ACEVS4US/ENVIRONMENT_BOARD/Environment2.brd

## EAGLE design Environment2.brd (2021-01-10)

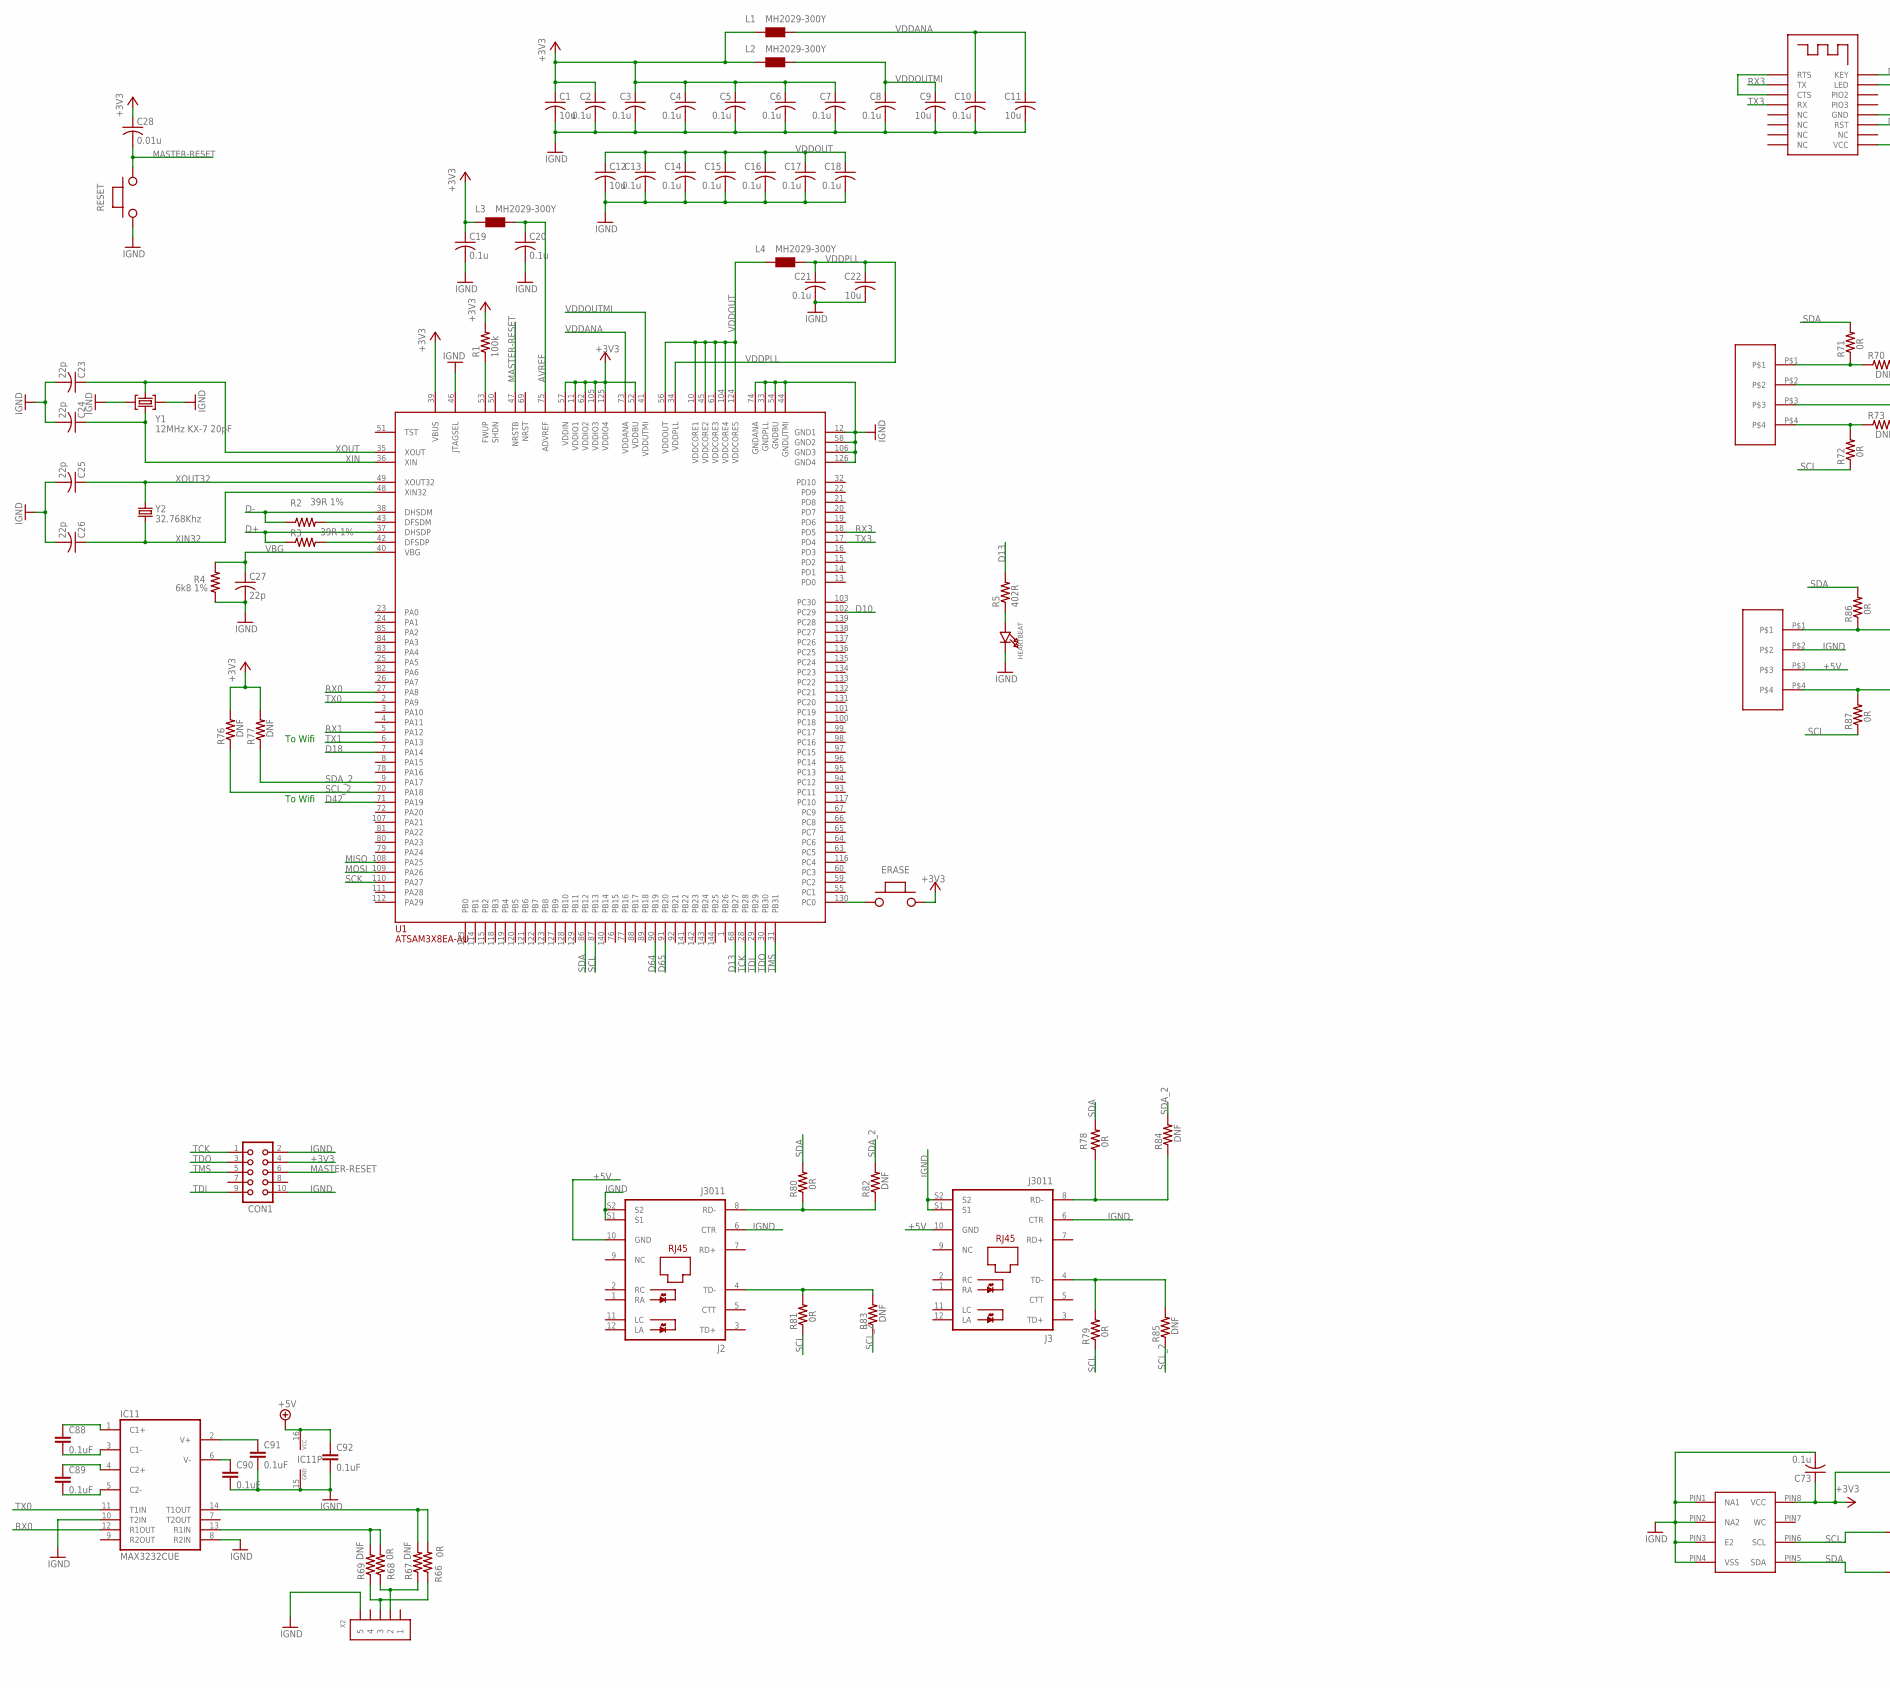
[picture p1: schematic Environment2.sch, part in row 1, column 1]

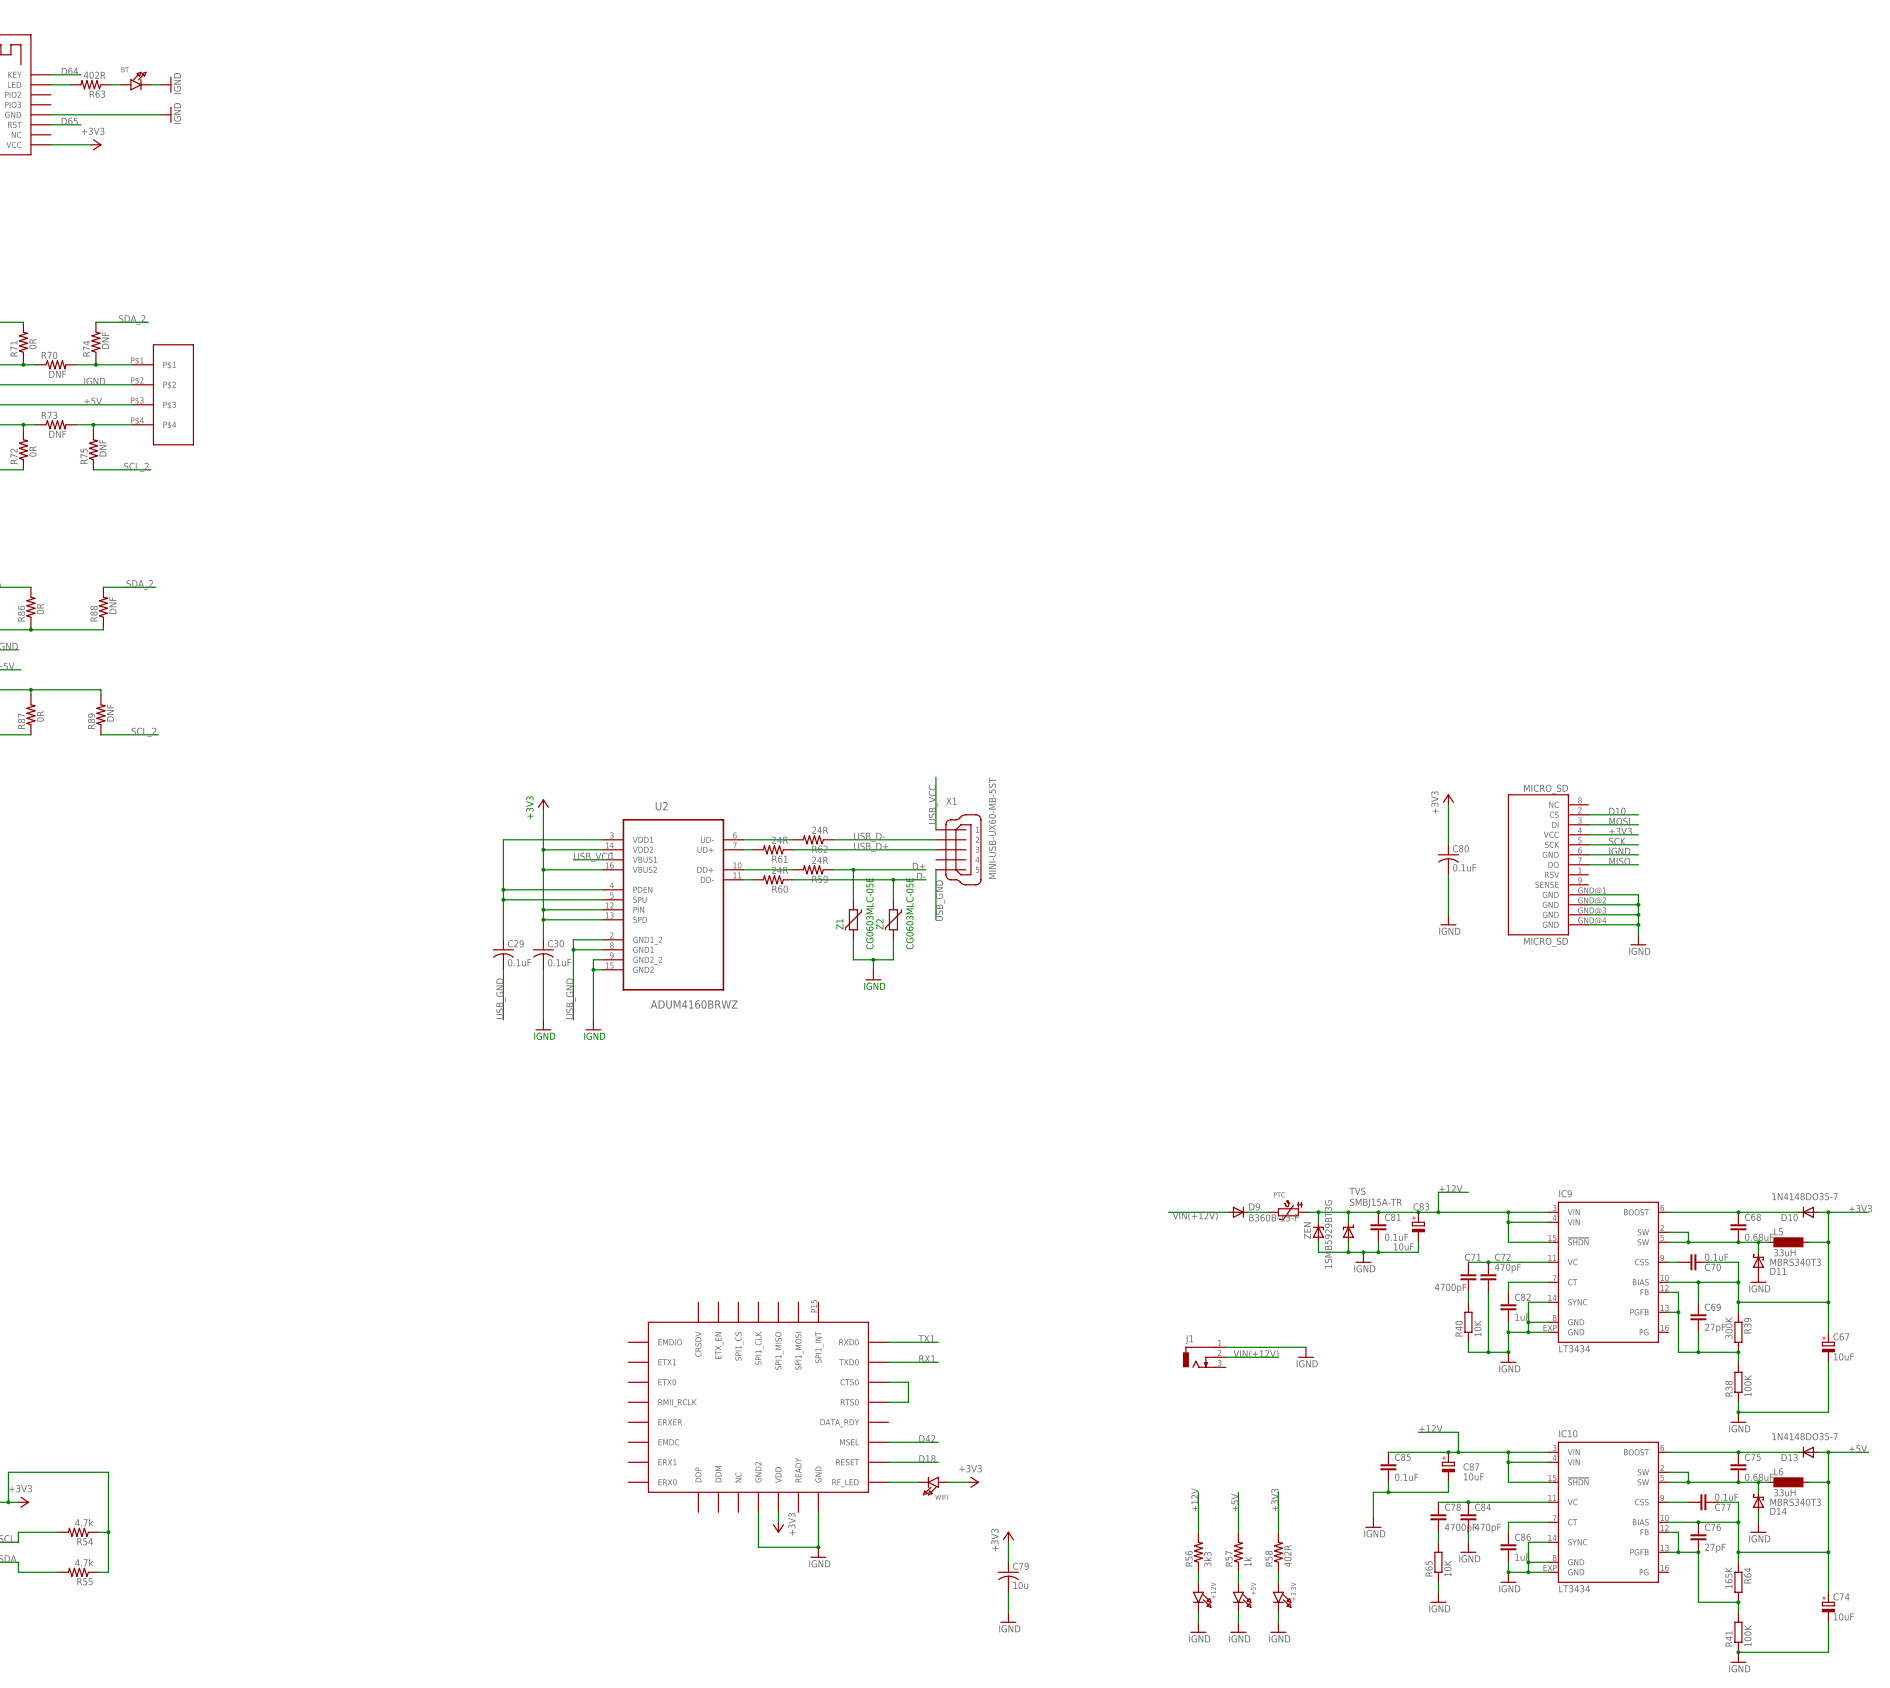
[picture p2: schematic Environment2.sch, part in row 1, column 2]

Parts:
+3.3V, +5V, +12V: LED0805; CHIPLED_0805
BT: LED0805; CHIPLED_0805
C1, C9, C11, C12, C22, C79: 10u; C0805
C2, C3, C4, C5, C6, C7, C8, C10, C13, C14, C15, C16, C17, C18, C19, C20, C21, C73: 0.1u; C0805
C23, C24: 22p; C1206
C25, C26, C27: 22p; C0805
C28: 0.01u; C0805
C29, C30, C80: 0.1uF; C0805
C67, C74, C83, C87: 10uF; SMC_D
C68, C75: 0.68uF; C0603
C69, C76: 27pF; C0603
C70, C77, C81, C85, C88, C89, C90, C91, C92: 0.1uF; C0603
C71, C78: 4700pF; C0603
C72, C84: 470pF; C0603
C82, C86: 1uF; C0603
CON1: CON10
D9: B360B-13-F; SMB
D10, D13: 1N4148DO35-7; DO35-7
D11, D14: MBRS340T3; SMC
ERASE: PUCHBUTTON
HEARTBEAT: LED0805; CHIPLED_0805
IC9, IC10: LT3434; TSSOP16EXP
IC11: MAX3232CUE; TSSOP16
J1: DCJ0303
J2, J3: J3011; J30
L1, L2, L3, L4: MH2029-300Y; 0805
L5, L6: 33uH; MS85
MICRO_SD: MICRO_SD; MICROSD_PP
PTC: PTC1812
R1: 100k; R0805
R2, R3: 39R 1%; R0805
R4: 6k8 1%; R0805
R5, R58, R63: 402R; R0805
R38, R41: 100K; R0603
R39: 300K; R0603
R40, R65: 10K; R0603
R54, R55: 4.7k; R0805
R56: 3k3; R0805
R57: 1k; R0805
R59, R60, R61, R62: 24R; R0805
R64: 165K; R0603
R66, R68, R71, R72, R78, R79, R80, R81, R86, R87: 0R; R0805
R67, R69, R70, R73, R74, R75, R76, R77, R82, R83, R84, R85, R88, R89: DNF; R0805
RESET: PUCHBUTTON
TVS: SMBJ15A-TR; SMBJ
U1: ATSAM3X8EA-AU; LQFP144
U2: ADUM4160BRWZ; SOIC127P1032X265-16N
U7: CK_CUSTOM_M24M02-DRMN6TP; CK_CUSTOM_SOIC8
U8, U9, U10: 560020-04; 560020-4
U$1: NANOREACH
U$3: HM-13
WIFI: LED0805; CHIPLED_0805
X1: MINI-USB-UX60-MB-5ST; UX60-MB-5ST
X2: CONN_5-1-502386; CM-502386-05
Y1: 12MHz KX-7 20pF; CRYSTAL-3.2-2.5
Y2: 32.768Khz; ARDUINO_WIFI_SHIELD_V018_TG_RESONATOR_EPSON_FC_145
Z1, Z2: CG0603MLC-05E; CT/CN0603
ZEN: 1SMB5929BT3G; SMB

Connections:
+3V3: C1.1, C2.1, C3.1, C4.1, C5.1, C6.1, C7.1, C19.1, C28.1, C30.1, C67.+, C69.1, C70.2, C73.1, C79.1, C80.1, CON1.4, D10.A, ERASE.P$2, IC9.10 (BIAS), L1.1, L2.1, L3.1, L5.2, MICRO_SD.4 (VCC), R1.2, R39.1, R54.1, R55.1, R58.2, R76.2, R77.2, U1.11 (VDDIO1), U1.39 (VBUS), U1.52 (VDDBU), U1.57 (VDDIN), U1.62 (VDDIO2), U1.105 (VDDIO3), U1.125 (VDDIO4), U2.12 (PIN), U2.13 (SPD), U2.14 (VDD2), U2.16 (VBUS2), U7.PIN8 (VCC), U$1.P1 (VDD), U$3.P$9 (VCC), WIFI.A
+5V: C74.+, C76.1, C77.2, C92.1, D13.A, IC10.10 (BIAS), IC11.16 (VCC), J2.10 (GND), L6.2, R57.2, R64.1, U8.P$3, U9.P$3, U10.P$3
+12V: C81.1, C83.+, C85.1, C87.+, IC9.3 (VIN), IC9.4 (VIN), IC9.15 (!SHDN), IC10.3 (VIN), IC10.4 (VIN), IC10.15 (!SHDN), PTC.P$1 (1), R56.2, TVS.C, ZEN.C
A: R70.2, R74.1, U9.P$1
AVREF: C20.1, L3.2, U1.75 (ADVREF)
B: R73.2, R75.2, U9.P$4
D10: MICRO_SD.2 (CS), U1.102 (PC29)
D13: R5.2, U1.68 (PB27)
D18: U1.7 (PA14), U$1.P9 (RESET)
D42: U1.71 (PA19), U$1.P8 (MSEL)
D64: U1.90 (PB19), U$3.P$16 (KEY)
D65: U1.91 (PB20), U$3.P$11 (RST)
D+: R3.1, R59.1, U1.37 (DHSDP), Z1.1
D-: R2.1, R60.1, U1.38 (DHSDM), Z2.1
ERASE_S: ERASE.P$1, U1.130 (PC0)
IGND: +3.3V.C, +5V.C, +12V.C, BT.C, C1.2, C2.2, C3.2, C4.2, C5.2, C6.2, C7.2, C8.2, C9.2, C10.2, C11.2, C12.2, C13.2, C14.2, C15.2, C16.2, C17.2, C18.2, C19.2, C20.2, C21.2, C22.2, C23.2, C24.2, C25.2, C26.2, C27.2, C30.2, C67.-, C72.2, C73.2, C74.-, C79.2, C80.2, C81.2, C82.2, C83.-, C84.2, C85.2, C86.2, C87.-, C90.2, C91.2, C92.2, CON1.2, CON1.10, D11.A, D14.A, HEARTBEAT.C, IC9.8 (GND), IC9.14 (SYNC), IC9.EXP (GND), IC10.8 (GND), IC10.14 (SYNC), IC10.EXP (GND), IC11.8 (R2IN), IC11.10 (T2IN), IC11.15 (GND), J1.1, J2.6 (CTR), J2.S1, J2.S2, J3.6 (CTR), J3.S1, J3.S2, MICRO_SD.6 (GND), MICRO_SD.GND@1 (GND), MICRO_SD.GND@2 (GND), MICRO_SD.GND@3 (GND), MICRO_SD.GND@4 (GND), R4.1, R38.1, R40.1, R41.1, R65.1, RESET.P$1, TVS.A, U1.12 (GND1), U1.33 (GNDPLL), U1.44 (GNDUTMI), U1.46 (JTAGSEL), U1.54 (GNDBU), U1.58 (GND2), U1.74 (GNDANA), U1.106 (GND3), U1.126 (GND4), U2.9 (GND2_2), U2.15 (GND2), U7.PIN1 (NA1), U7.PIN2 (NA2), U7.PIN3 (E2), U7.PIN4 (VSS), U8.P$2, U9.P$2, U10.P$2, U$1.P2 (GND), U$1.P20 (GND2), U$3.P$12 (GND), X2.5, Y1.2 (GND), Y1.4 (GND), Z1.2, Z2.2, ZEN.A
MASTER-RESET: C28.2, CON1.6, RESET.P$2, U1.47 (NRSTB)
MISO: MICRO_SD.7 (DO), U1.108 (PA25)
MOSI: MICRO_SD.3 (DI), U1.109 (PA26)
unnamed: +3.3V.A, R58.1
unnamed: D9.C, PTC.P$2 (2)
unnamed: +5V.A, R57.1
unnamed: C29.1, U2.3 (VDD1), U2.4 (PDEN), U2.5 (SPU)
unnamed: HEARTBEAT.A, R5.1
unnamed: U$3.P$1 (RTS), U$3.P$3 (CTS)
unnamed: R62.2, U2.6 (UD-)
unnamed: R61.2, U2.7 (UD+)
unnamed: C71.1, C72.1, IC9.11 (VC)
unnamed: C70.1, IC9.9 (CSS)
unnamed: C68.1, D10.C, IC9.6 (BOOST)
unnamed: C71.2, R40.2
unnamed: C68.2, D11.C, IC9.2 (SW), IC9.5 (SW), L5.1
unnamed: C82.1, IC9.7 (CT)
unnamed: R59.2, U2.10 (DD+)
unnamed: +12V.A, R56.1
unnamed: R60.2, U2.11 (DD-)
unnamed: BT.A, R63.1
unnamed: R63.2, U$3.P$15 (LED)
unnamed: U$1.P5 (CTS0), U$1.P6 (RTS0)
unnamed: R2.2, U1.43 (DFSDM)
unnamed: R3.2, U1.42 (DFSDP)
unnamed: R1.1, U1.53 (FWUP)
unnamed: C69.2, IC9.12 (FB), IC9.13 (PGFB), R38.2, R39.2
unnamed: C75.1, D13.C, IC10.6 (BOOST)
unnamed: C77.1, IC10.9 (CSS)
unnamed: C75.2, D14.C, IC10.2 (SW), IC10.5 (SW), L6.1
unnamed: C86.1, IC10.7 (CT)
unnamed: C78.1, C84.1, IC10.11 (VC)
unnamed: C78.2, R65.2
unnamed: C88.1, IC11.1 (C1+)
unnamed: C88.2, IC11.3 (C1-)
unnamed: C89.1, IC11.4 (C2+)
unnamed: R66.1, R69.1, X2.3
unnamed: R67.1, R68.1, X2.2
unnamed: R70.1, R71.1, U10.P$1
unnamed: R72.2, R73.1, U10.P$4
unnamed: J2.8 (RD-), R80.1, R82.1
unnamed: J2.4 (TD-), R81.2, R83.2
unnamed: J3.8 (RD-), R78.1, R84.1
unnamed: J3.4 (TD-), R79.2, R85.2
unnamed: R86.1, R88.1, U8.P$1
unnamed: R87.2, R89.2, U8.P$4
unnamed: C76.2, IC10.12 (FB), IC10.13 (PGFB), R41.2, R64.2
unnamed: C89.2, IC11.5 (C2-)
unnamed: C90.1, IC11.6 (V-)
unnamed: IC11.14 (T1OUT), R66.2, R67.2
unnamed: IC11.13 (R1IN), R68.2, R69.2
unnamed: C91.1, IC11.2 (V+)
RX0: IC11.12 (R1OUT), U1.27 (PA8)
RX1: U1.5 (PA12), U$1.P4 (TXD0)
RX3: U1.18 (PD5), U$3.P$2 (TX)
SCK: MICRO_SD.5 (SCK), U1.110 (PA27)
SCL: R54.2, R72.1, R79.1, R81.1, R87.1, U1.87 (PB13), U7.PIN6 (SCL)
SCL_2: R75.1, R76.1, R83.1, R85.1, R89.1, U1.70 (PA18)
SDA: R55.2, R71.2, R78.2, R80.2, R86.2, U1.86 (PB12), U7.PIN5 (SDA)
SDA_2: R74.2, R77.1, R82.2, R84.2, R88.2, U1.9 (PA17)
TCK: CON1.1, U1.28 (PB28)
TDI: CON1.9, U1.29 (PB29)
TDO: CON1.3, U1.30 (PB30)
TMS: CON1.5, U1.31 (PB31)
TX0: IC11.11 (T1IN), U1.2 (PA9)
TX1: U1.6 (PA13), U$1.P3 (RXD0)
TX3: U1.17 (PD4), U$3.P$4 (RX)
USB_D+: R61.1, X1.3
USB_D-: R62.1, X1.2
USB_GND: C29.2, U2.2 (GND1_2), U2.8 (GND1), X1.5
USB_VCC: U2.1 (VBUS1), X1.1
VBG: C27.1, R4.2, U1.40 (VBG)
VDDANA: C10.1, C11.1, L1.2, U1.73 (VDDANA)
VDDOUT: C12.1, C13.1, C14.1, C15.1, C16.1, C17.1, C18.1, L4.1, U1.10 (VDDCORE1), U1.45 (VDDCORE2), U1.56 (VDDOUT), U1.61 (VDDCORE3), U1.104 (VDDCORE4), U1.124 (VDDCORE5)
VDDOUTMI: C8.1, C9.1, L2.2, U1.41 (VDDUTMI)
VDDPLL: C21.1, C22.1, L4.2, U1.34 (VDDPLL)
VIN(+12V): D9.A, J1.2
WIFI: U$1.P10 (RF_LED), WIFI.C
XIN: C24.1, U1.36 (XIN), Y1.1 (C1)
XIN32: C26.1, U1.48 (XIN32), Y2.P$2 (2)
XOUT: C23.1, U1.35 (XOUT), Y1.3 (C2)
XOUT32: C25.1, U1.49 (XOUT32), Y2.P$1 (1)

Notes on the sheet:
To Wifi

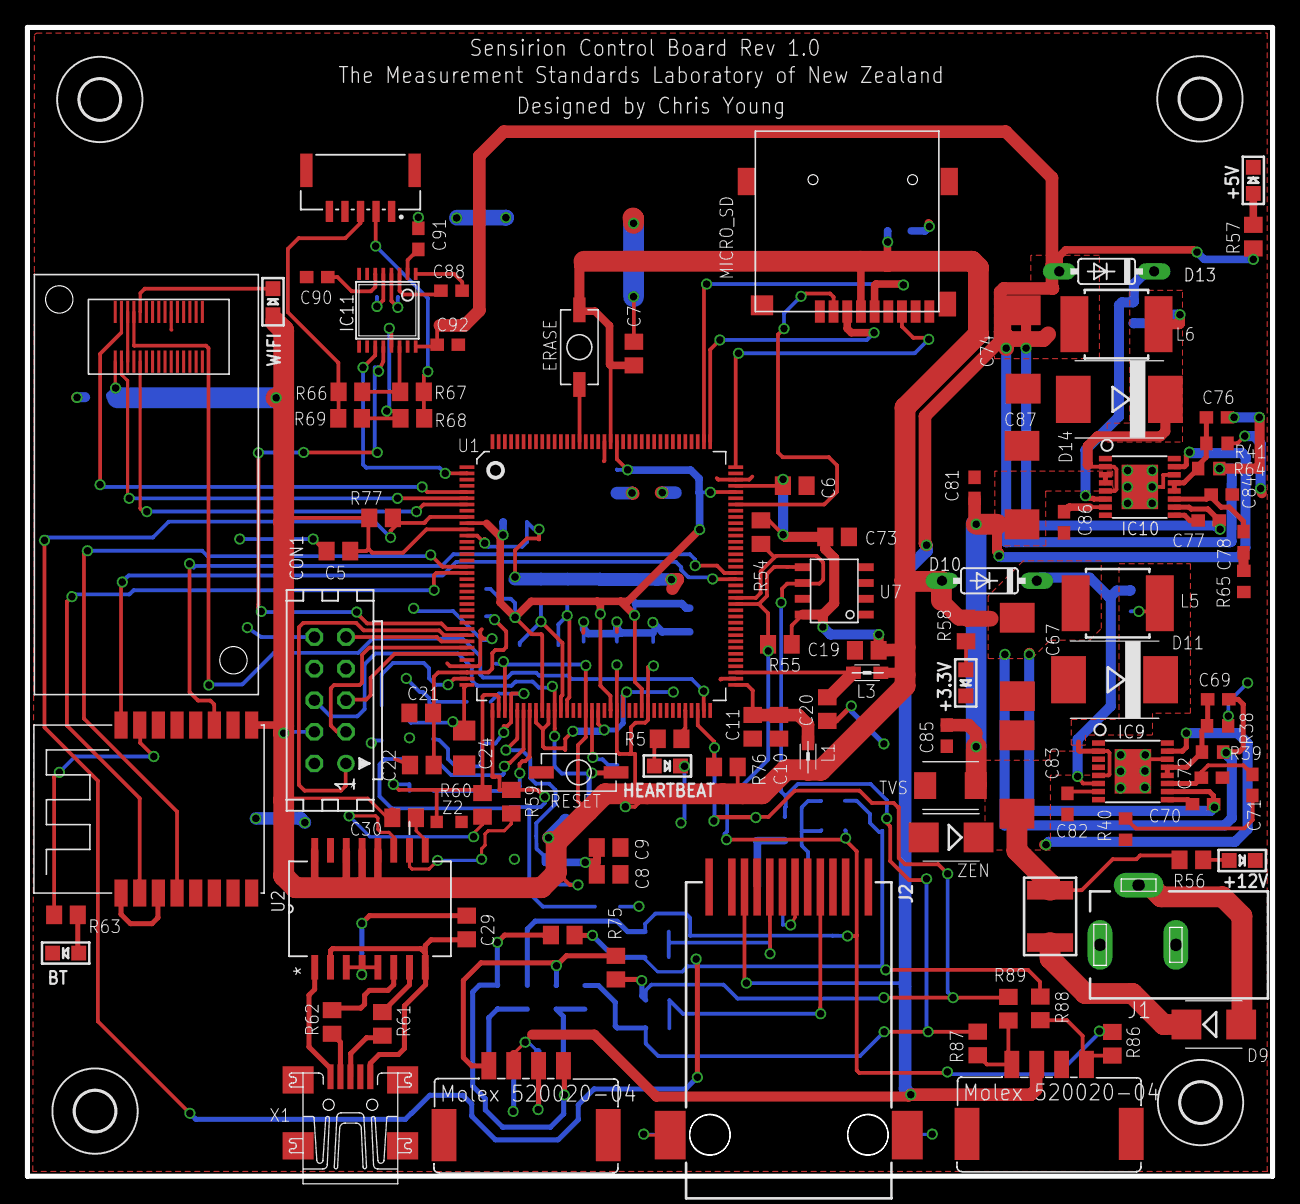
[picture p3: board Environment2.brd from above]

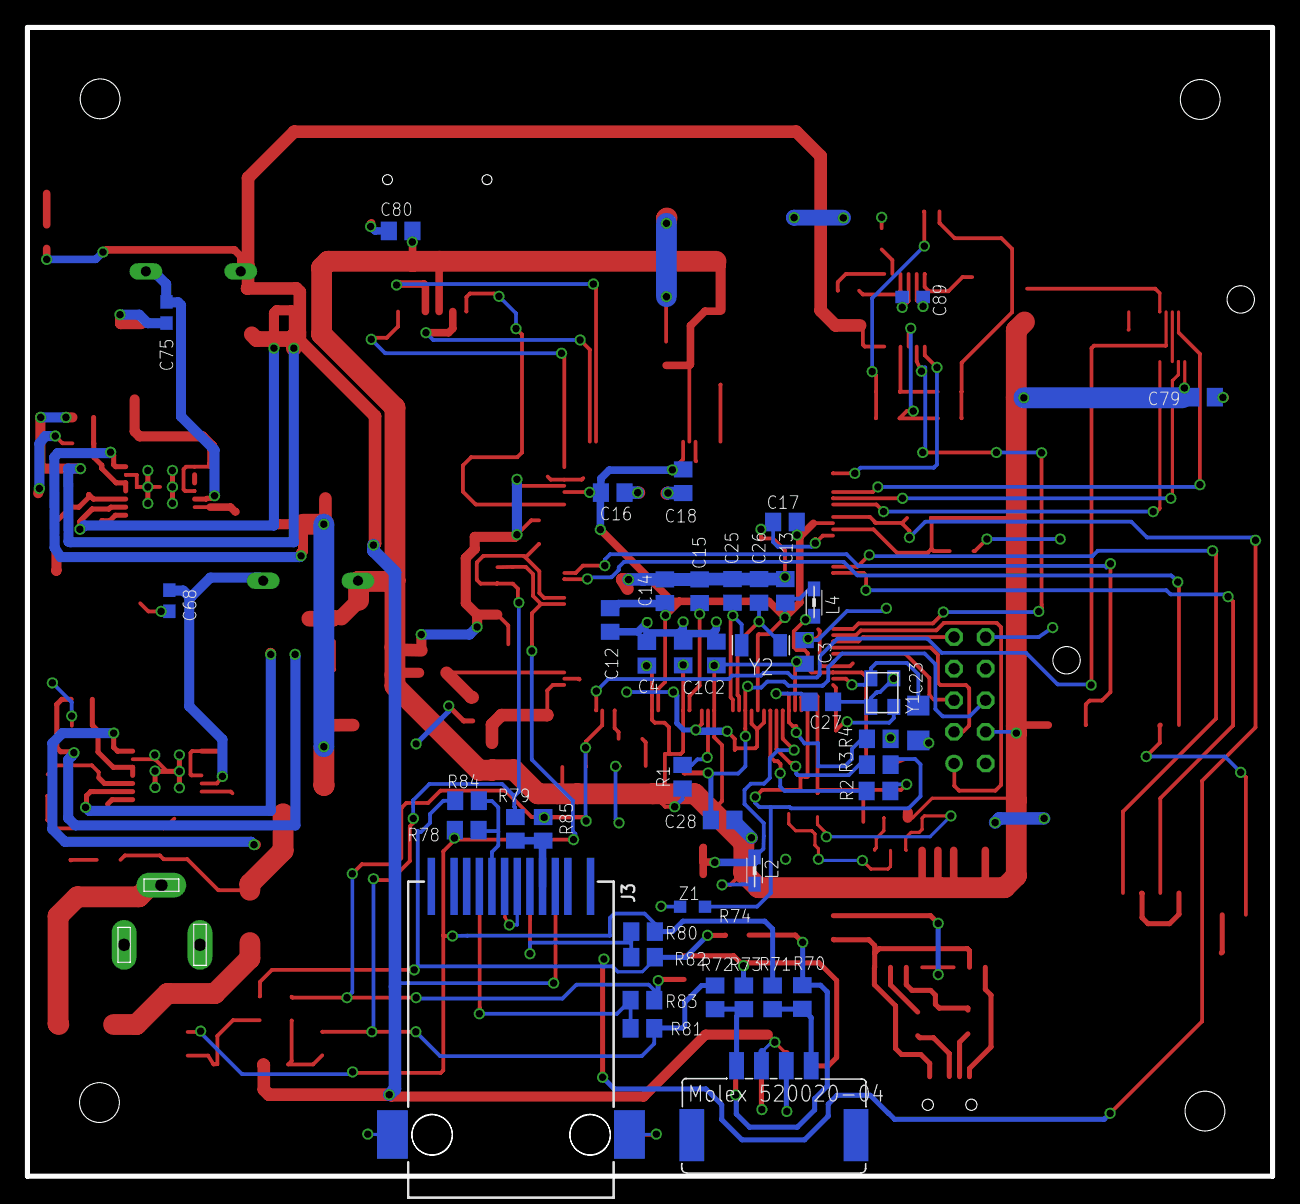
[picture p4: board Environment2.brd from below]

Board: 2 copper layers, 100.1 x 92.3 mm, 149 parts (44 on the bottom side), 98 nets.

Other parts of the board:
U$2, U$4, U$5, U$6: 3,2
